JorawarSingh09/Facial-Recognition-Vault/send_email_test.py/capture/motion_image004.jpg

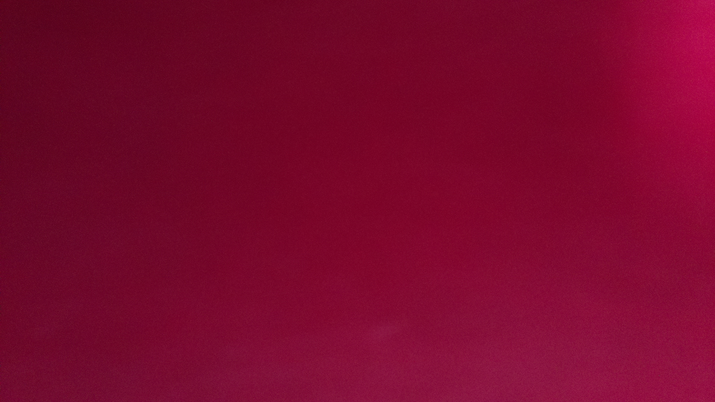
send_email_test.py/capture/motion_image004.jpg
