JorawarSingh09/Facial-Recognition-Vault/send_email_test.py/capture/motion_image002.jpg

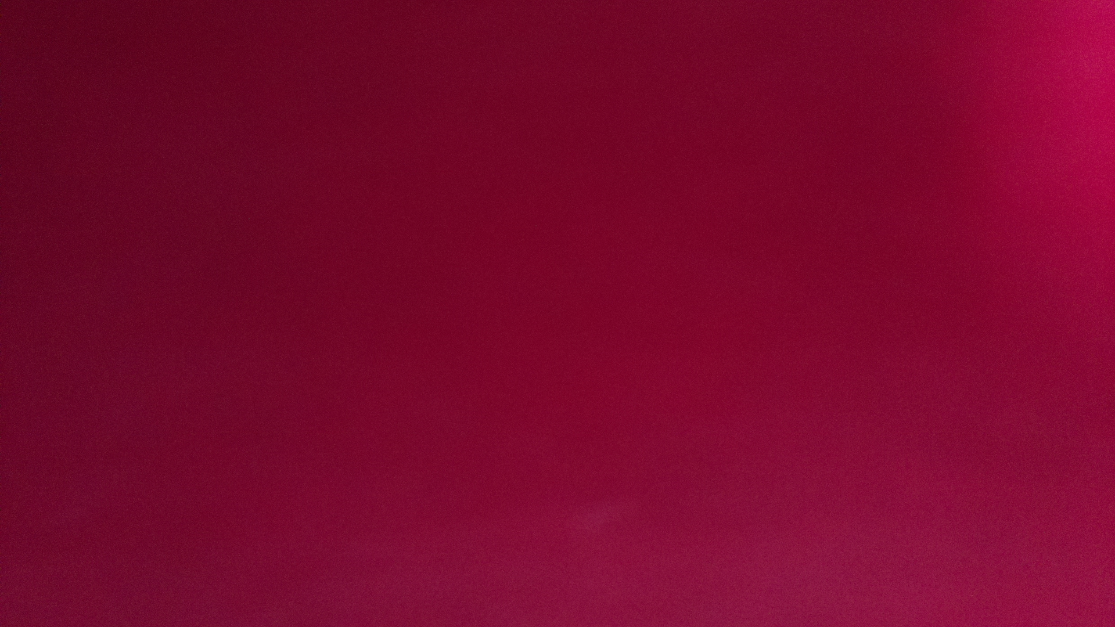
send_email_test.py/capture/motion_image002.jpg
