JorawarSingh09/Facial-Recognition-Vault/send_email_test.py/capture/motion_image005.jpg

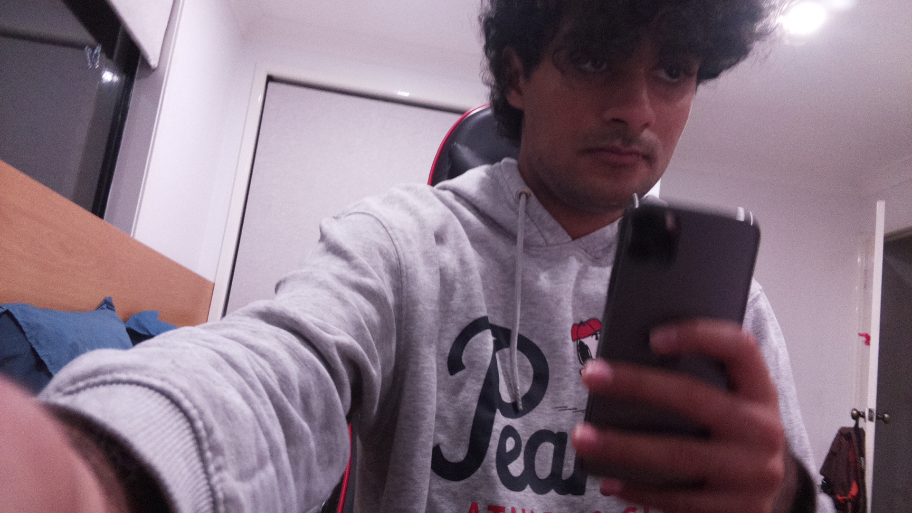
send_email_test.py/capture/motion_image005.jpg
